markniu/Laser-Filament-Motion-Sensor/filament_sensor.stl

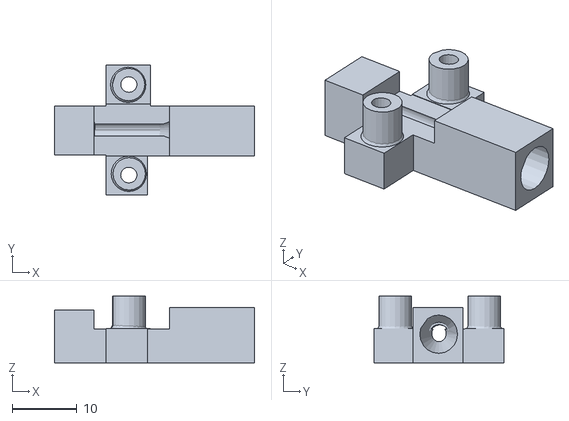
[picture p5: CAD file, 2023-08-01]
filament_sensor.stl
30.8 x 20.0 x 10.3
