markniu/Laser-Filament-Motion-Sensor/Schematic_Laser_Fliament.pdf

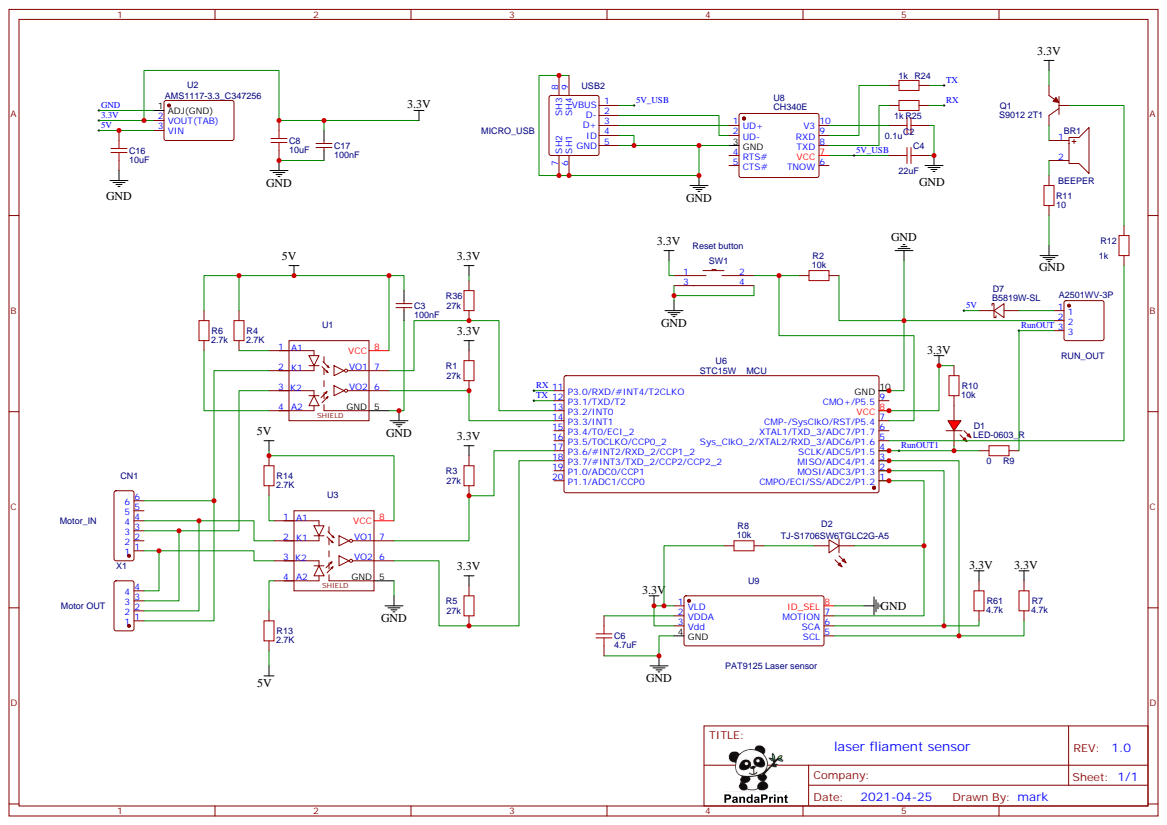
[picture p6: page 1]
