markniu/Laser-Filament-Motion-Sensor/(threads)

Thread 1 (2021-08-19):

Please add sch

mrx23dot, 2021-08-19:

markniu, 2021-08-20:
have added the schematic.

mrx23dot, 2021-08-20:
Thank you!
Would you also have the firmware?

I guess it needs to know the number of microsteps.
I would also add a sponge in the filament guide since it's an optical sensor.
Is it sensitive to the color of the filament? (eg black vs white)

markniu, 2021-08-20:
There is a Fsensor_Tool that can set the sensitivity,output signal logic,alarm time, it not necessary for most of user to change the firmware which may confuse and take more hard work for users.

markniu, 2021-08-20:
I tested several colors of filaments, and this sensor is very sensitive to all of these colors, including black, red, white, and transparent filaments.

mrx23dot, 2021-08-20:
Ah okay it's not open source then.
Thanks anyway! Great project!

Closed 2021-08-20.
